sorinbotirla/parkside-telemeter-esp32cam-rangefinder/notes.txt

SDA pin 13 white
SCL pin 2 blue
keyoard pin 14 white/transparent
power pin 15 red/black
