sorinbotirla/parkside-telemeter-esp32cam-rangefinder/images/20251103_020656.jpg

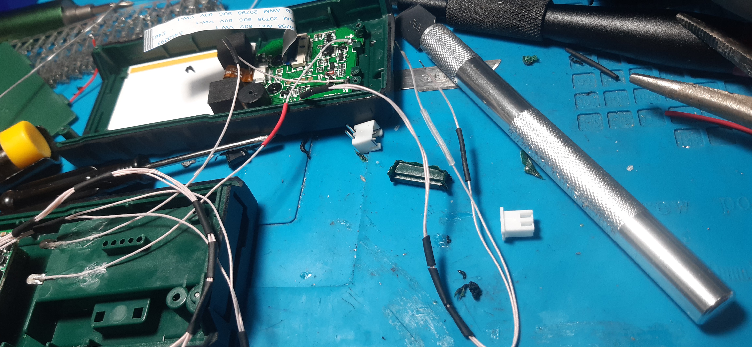
images/20251103_020656.jpg
