sorinbotirla/parkside-telemeter-esp32cam-rangefinder/images/20251116_204047.jpg

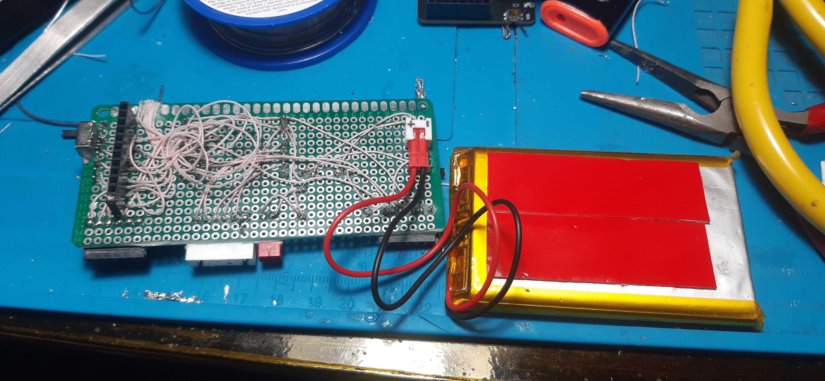
images/20251116_204047.jpg
