sorinbotirla/parkside-telemeter-esp32cam-rangefinder/images/20251116_204103.jpg

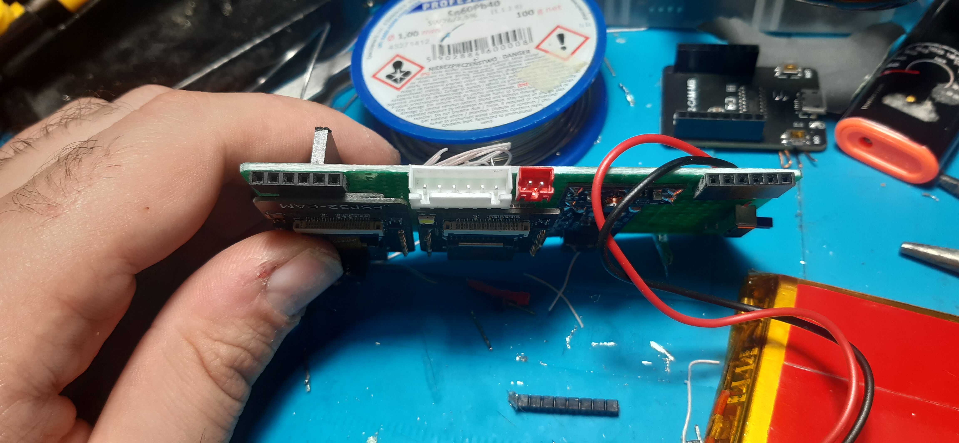
images/20251116_204103.jpg
