sorinbotirla/parkside-telemeter-esp32cam-rangefinder/images/20251119_194628.jpg

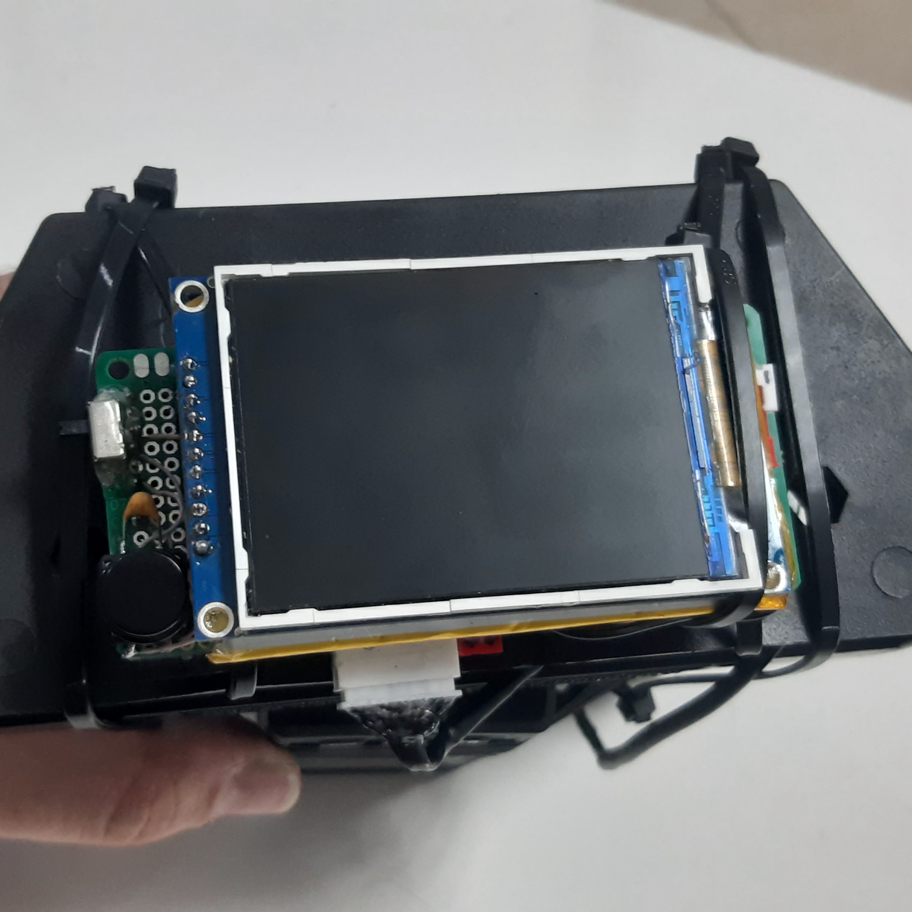
images/20251119_194628.jpg
