sorinbotirla/parkside-telemeter-esp32cam-rangefinder/images/20251119_194636.jpg

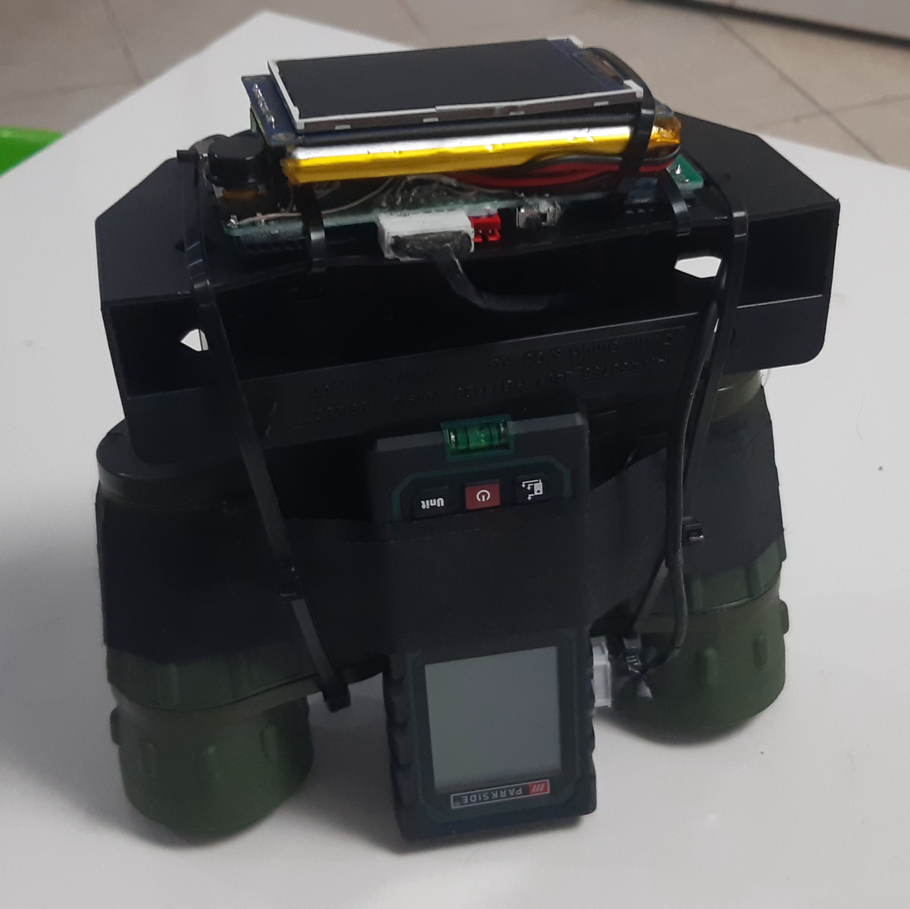
images/20251119_194636.jpg
