sorinbotirla/parkside-telemeter-esp32cam-rangefinder/images/esp32s-pinout.png

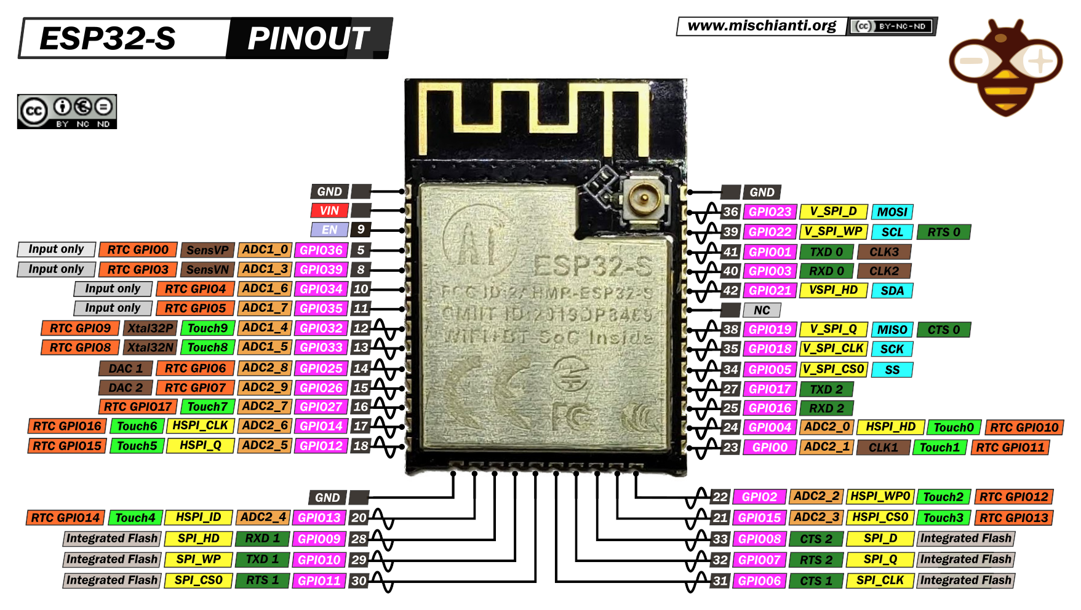
images/esp32s-pinout.png
