sorinbotirla/parkside-telemeter-esp32cam-rangefinder/images/F09LCGRLXEP8742.jpg

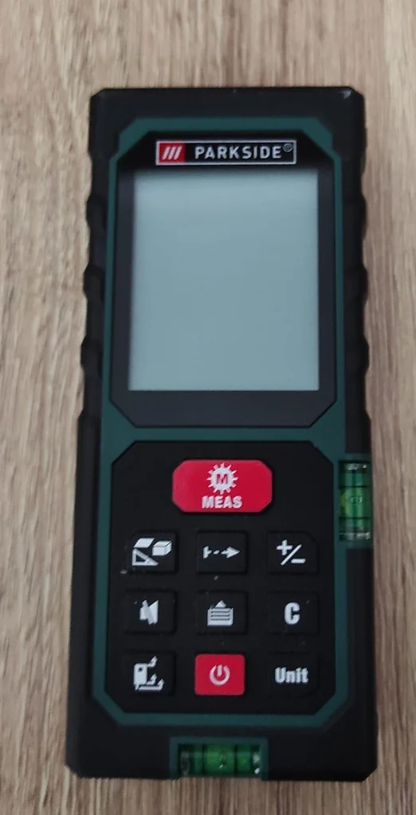
images/F09LCGRLXEP8742.jpg
