sorinbotirla/parkside-telemeter-esp32cam-rangefinder/cameradisplay/cameradisplay.ino

#include <Arduino.h>
#include "esp_camera.h"
#include <TFT_eSPI.h>

// ====================================================
// TFT DISPLAY
// ====================================================
TFT_eSPI tft = TFT_eSPI();
#define TFT_ROTATION 1

// ====================================================
// UART2 – receives distance from telemeter board
// ====================================================

// NOTE: GPIO4 is used here.
// This ONLY works if the flash LED on GPIO4 is removed.
// If you want RX2 on GPIO13 instead, tell me.

#define UART2_RX_PIN 13
#define UART2_TX_PIN -1   // unused

String lastDistance = "0m";   // <-- default value

// Crosshair
#define CROSS_LEN  12   // line length
#define CROSS_GAP   4   // empty center space

// Laser icon
bool laserActive = false;
#define LASER_ICON_W 33
#define LASER_ICON_H 33

// 'LaserIcon', 33x33px
static const uint16_t laserIcon[1089] = {
  0xFFFF, 0xFFFF, 0xFFFF, 0xFFFF, 0xFFFF, 0xFFFF, 0xFFFF, 0xFFFF, 0xFFFF, 0xFFFF, 0xFFFF, 0xFFFF,
  0xFFFF, 0xFFFF, 0xFFFF, 0xF800, 0xF800, 0xF800, 0xFFFF, 0xFFFF, 0xFFFF, 0xFFFF, 0xFFFF, 0xFFFF,
  0xFFFF, 0xFFFF, 0xFFFF, 0xFFFF, 0xFFFF, 0xFFFF, 0xFFFF, 0xFFFF, 0xFFFF, 0xFFFF, 0xFFFF, 0xFFFF,
  0xFFFF, 0xFFFF, 0xFFFF, 0xFFFF, 0xFFFF, 0xFFFF, 0xFFFF, 0xFFFF, 0xFFFF, 0xFFFF, 0xFFFF, 0xF800,
  0xF800, 0xF800, 0xF800, 0xF800, 0xFFFF, 0xFFFF, 0xFFFF, 0xFFFF, 0xFFFF, 0xFFFF, 0xFFFF, 0xFFFF,
  0xFFFF, 0xFFFF, 0xFFFF, 0xFFFF, 0xFFFF, 0xFFFF, 0xFFFF, 0xFFFF, 0xFFFF, 0xFFFF, 0xFFFF, 0xFFFF,
  0xFFFF, 0xFFFF, 0xFFFF, 0xFFFF, 0xFFFF, 0xFFFF, 0xFFFF, 0xFFFF, 0xF800, 0xF800, 0xF800, 0xF800,
  0xF800, 0xFFFF, 0xFFFF, 0xFFFF, 0xFFFF, 0xFFFF, 0xFFFF, 0xFFFF, 0xFFFF, 0xFFFF, 0xFFFF, 0xFFFF,
  0xFFFF, 0xFFFF, 0xFFFF, 0xFFFF, 0xFFFF, 0xFFFF, 0xFFFF, 0xFFFF, 0xFFFF, 0xFFFF, 0xFFFF, 0xFFFF,
  0xFFFF, 0xFFFF, 0xFFFF, 0xFFFF, 0xFFFF, 0xF800, 0xF800, 0xF800, 0xF800, 0xF800, 0xFFFF, 0xFFFF,
  0xFFFF, 0xFFFF, 0xFFFF, 0xFFFF, 0xFFFF, 0xFFFF, 0xFFFF, 0xFFFF, 0xFFFF, 0xFFFF, 0xFFFF, 0xFFFF,
  0xFFFF, 0xFFFF, 0xFFFF, 0xFFFF, 0xFFFF, 0xF800, 0xF800, 0xF800, 0xFFFF, 0xFFFF, 0xFFFF, 0xFFFF,
  0xFFFF, 0xFFFF, 0xF800, 0xF800, 0xF800, 0xF800, 0xF800, 0xFFFF, 0xFFFF, 0xFFFF, 0xFFFF, 0xFFFF,
  0xFFFF, 0xFFFF, 0xFFFF, 0xFFFF, 0xFFFF, 0xFFFF, 0xFFFF, 0xFFFF, 0xFFFF, 0xFFFF, 0xFFFF, 0xFFFF,
  0xFFFF, 0xF800, 0xF800, 0xF800, 0xF800, 0xF800, 0xFFFF, 0xFFFF, 0xFFFF, 0xFFFF, 0xFFFF, 0xF800,
  0xF800, 0xF800, 0xF800, 0xF800, 0xFFFF, 0xFFFF, 0xFFFF, 0xFFFF, 0xFFFF, 0xF800, 0xF800, 0xF800,
  0xFFFF, 0xFFFF, 0xFFFF, 0xFFFF, 0xFFFF, 0xFFFF, 0xFFFF, 0xFFFF, 0xFFFF, 0xFFFF, 0xF800, 0xF800,
  0xF800, 0xF800, 0xF800, 0xF800, 0xFFFF, 0xFFFF, 0xFFFF, 0xFFFF, 0xF800, 0xF800, 0xF800, 0xF800,
  0xF800, 0xFFFF, 0xFFFF, 0xFFFF, 0xFFFF, 0xF800, 0xF800, 0xF800, 0xF800, 0xF800, 0xFFFF, 0xFFFF,
  0xFFFF, 0xFFFF, 0xFFFF, 0xFFFF, 0xFFFF, 0xFFFF, 0xFFFF, 0xF800, 0xF800, 0xF800, 0xF800, 0xF800,
  0xF800, 0xF800, 0xFFFF, 0xFFFF, 0xFFFF, 0xF800, 0xF800, 0xF800, 0xF800, 0xF800, 0xFFFF, 0xFFFF,
  0xFFFF, 0xF800, 0xF800, 0xF800, 0xF800, 0xF800, 0xF800, 0xFFFF, 0xFFFF, 0xFFFF, 0xFFFF, 0xFFFF,
  0xFFFF, 0xFFFF, 0xFFFF, 0xFFFF, 0xFFFF, 0xF800, 0xF800, 0xF800, 0xF800, 0xF800, 0xF800, 0xF800,
  0xFFFF, 0xFFFF, 0xF800, 0xF800, 0xF800, 0xF800, 0xF800, 0xFFFF, 0xFFFF, 0xF800, 0xF800, 0xF800,
  0xF800, 0xF800, 0xF800, 0xF800, 0xFFFF, 0xFFFF, 0xFFFF, 0xFFFF, 0xFFFF, 0xFFFF, 0xFFFF, 0xFFFF,
  0xFFFF, 0xFFFF, 0xFFFF, 0xF800, 0xF800, 0xF800, 0xF800, 0xF800, 0xF800, 0xFFFF, 0xFFFF, 0xF8A2,
  0xF841, 0xF800, 0xF800, 0xF800, 0xFFFF, 0xFFFF, 0xF800, 0xF800, 0xF800, 0xF800, 0xF800, 0xF800,
  0xFFFF, 0xFFFF, 0xFFFF, 0xFFFF, 0xFFFF, 0xFFFF, 0xFFFF, 0xFFFF, 0xFFFF, 0xFFFF, 0xFFFF, 0xFFFF,
  0xFFFF, 0xF800, 0xF800, 0xF800, 0xF800, 0xF800, 0xFFFF, 0xFFFF, 0xFFFF, 0xFFFF, 0xFFFF, 0xFFFF,
  0xFFFF, 0xFFFF, 0xFFFF, 0xF800, 0xF800, 0xF800, 0xF800, 0xF800, 0xFFFF, 0xFFFF, 0xFFFF, 0xFFFF,
  0xFFFF, 0xFFFF, 0xFFFF, 0xFFFF, 0xFFFF, 0xFFFF, 0xFFFF, 0xFFFF, 0xFFFF, 0xFFFF, 0xFFFF, 0xF800,
  0xF800, 0xF800, 0xFFFF, 0xFFFF, 0xFFFF, 0xFFFF, 0xFFFF, 0xFFFF, 0xFFFF, 0xFFFF, 0xFFFF, 0xFFFF,
  0xFFFF, 0xF800, 0xF800, 0xF800, 0xFFFF, 0xFFFF, 0xFFFF, 0xFFFF, 0xFFFF, 0xFFFF, 0xFFFF, 0xFFFF,
  0xFFFF, 0xFFFF, 0xFFFF, 0xFFFF, 0xFFFF, 0xFFFF, 0xFFFF, 0xFFFF, 0xFFFF, 0xFFFF, 0xFFFF, 0xFFFF,
  0xFFFF, 0xFFFF, 0xFFFF, 0xFFFF, 0xFFFF, 0xFFFF, 0xFFFF, 0xFFFF, 0xFFFF, 0xFFFF, 0xFFFF, 0xFFFF,
  0xFFFF, 0xFFFF, 0xFFFF, 0xFFFF, 0xFFFF, 0xFFFF, 0xFFFF, 0xFFFF, 0xFFFF, 0xFFFF, 0xFFFF, 0xFFFF,
  0xFFFF, 0xFFFF, 0xFFFF, 0xFFFF, 0xFFFF, 0xFFFF, 0xFFFF, 0xFFFF, 0xFFFF, 0xFFFF, 0xFFFF, 0xF800,
  0xF800, 0xF800, 0xF800, 0xFFFF, 0xFFFF, 0xFFFF, 0xFFFF, 0xFFFF, 0xFFFF, 0xFFFF, 0xFFFF, 0xFFFF,
  0xFFFF, 0xFFFF, 0xFFFF, 0xFFFF, 0xFFFF, 0xFFFF, 0xFFFF, 0xF800, 0xF800, 0xF800, 0xF800, 0xF800,
  0xF800, 0xF800, 0xF800, 0xF800, 0xFFFF, 0xFFFF, 0xFFFF, 0xF800, 0xF800, 0xF800, 0xF800, 0xF800,
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
};




// ====================================================
// HISTORY OF MEASUREMENTS (right side of screen)
// ====================================================

static const int MAX_HISTORY       = 6;  // how many old values to remember
static const int HIST_AREA_WIDTH   = 40;  // approx width used on the right side
static const int HIST_LINE_HEIGHT  = 12;  // vertical spacing for lines

String historyValues[MAX_HISTORY];
int    historyCount = 0;

void addHistoryEntry(const String &val) {
  if (val.length() == 0) return;
  if (val == "0m") return; // avoid storing the initial placeholder

  if (historyCount < MAX_HISTORY) {
    historyValues[historyCount++] = val;
  } else {
    // shift up, drop oldest
    for (int i = 1; i < MAX_HISTORY; i++) {
      historyValues[i - 1] = historyValues[i];
    }
    historyValues[MAX_HISTORY - 1] = val;
  }
}

// ====================================================
// ESP32-CAM AI THINKER PIN DEFINITIONS
// ====================================================

#define PWDN_GPIO_NUM     32
#define RESET_GPIO_NUM    -1
#define XCLK_GPIO_NUM      0
#define SIOD_GPIO_NUM     26
#define SIOC_GPIO_NUM     27

#define Y9_GPIO_NUM       35
#define Y8_GPIO_NUM       34
#define Y7_GPIO_NUM       39
#define Y6_GPIO_NUM       36
#define Y5_GPIO_NUM       21
#define Y4_GPIO_NUM       19
#define Y3_GPIO_NUM       18
#define Y2_GPIO_NUM        5

#define VSYNC_GPIO_NUM    25
#define HREF_GPIO_NUM     23
#define PCLK_GPIO_NUM     22

// ====================================================
// CAMERA INIT
// ====================================================

bool init_camera() {
  camera_config_t c;

  c.ledc_channel = LEDC_CHANNEL_0;
  c.ledc_timer   = LEDC_TIMER_0;

  c.pin_d0 = Y2_GPIO_NUM;
  c.pin_d1 = Y3_GPIO_NUM;
  c.pin_d2 = Y4_GPIO_NUM;
  c.pin_d3 = Y5_GPIO_NUM;
  c.pin_d4 = Y6_GPIO_NUM;
  c.pin_d5 = Y7_GPIO_NUM;
  c.pin_d6 = Y8_GPIO_NUM;
  c.pin_d7 = Y9_GPIO_NUM;

  c.pin_xclk = XCLK_GPIO_NUM;
  c.pin_pclk = PCLK_GPIO_NUM;
  c.pin_vsync = VSYNC_GPIO_NUM;
  c.pin_href  = HREF_GPIO_NUM;

  c.pin_sccb_sda = SIOD_GPIO_NUM;
  c.pin_sccb_scl = SIOC_GPIO_NUM;

  c.pin_pwdn  = PWDN_GPIO_NUM;
  c.pin_reset = RESET_GPIO_NUM;

  c.xclk_freq_hz = 20000000;

  c.frame_size   = FRAMESIZE_QVGA;     // 320x240
  c.pixel_format = PIXFORMAT_RGB565;   // for TFT
  c.fb_count     = 2;
  c.grab_mode    = CAMERA_GRAB_LATEST;
  c.fb_location  = psramFound() ? CAMERA_FB_IN_PSRAM : CAMERA_FB_IN_DRAM;

  esp_err_t err = esp_camera_init(&c);
  return (err == ESP_OK);
}

// ====================================================
// DRAW OVERLAY - White text bottom-center, no box
// ====================================================

void drawDistanceOverlay(const String &s) {
  tft.setTextColor(TFT_WHITE, TFT_BLACK /*ignored unless background enabled*/);
  tft.setTextSize(2);

  int16_t textW = tft.textWidth(s);
  int16_t x = (320 - textW) / 2;
  int16_t y = 240 - 26 + 4;  // bottom area

  // Draw text only, no background
  tft.setCursor(x, y);
  tft.print(s);
}

// ====================================================
// DRAW HISTORY OVERLAY - Right side, yellow text, no box
// ====================================================

void drawHistoryOverlay() {
  if (historyCount == 0) return;

  tft.setTextSize(1);     // small font so it fits in the strip
  tft.setTextColor(TFT_GREEN, TFT_BLACK /*ignored unless background enabled*/);

  int16_t x = 320 - HIST_AREA_WIDTH + 2;
  int16_t y = 240 - HIST_LINE_HEIGHT;  // start from bottom

  // draw from newest (bottom) to oldest (top)
  for (int i = historyCount - 1; i >= 0; i--) {
    if (y < 0) break;  // off-screen
    tft.setCursor(x, y);
    tft.print(historyValues[i]);
    y -= HIST_LINE_HEIGHT;
  }
}

// ====================================================
// NORMALIZE/VALIDATE DISTANCE STRINGS
// ====================================================

String normalizeDistance(const String &raw) {
  String s = raw;
  s.trim();

  // Case: 255 (no unit)
  if (s == "255") {
    return lastDistance;
  }
    
  // Case: telemeter sends "---" or empty
  if (s == "---" || s.length() == 0) {
    return lastDistance;
  }

  // Case: must end with 'm'
  if (!s.endsWith("m")) {
    return lastDistance;
  }

  // Remove the trailing 'm'
  String numberPart = s.substring(0, s.length() - 1);

  // Validate the number part: digits or digits+dot
  bool valid = true;
  bool dotSeen = false;

  for (int i = 0; i < numberPart.length(); i++) {
    char c = numberPart[i];
    if (c >= '0' && c <= '9') continue;
    if (c == '.' && !dotSeen) {
      dotSeen = true;
      continue;
    }
    valid = false;
    break;
  }

  if (!valid || numberPart.length() == 0) {
    return lastDistance;
  }

  // Everything valid, return "[number]m"
  return numberPart + "m";
}

void drawCrosshair() {
  int cx = 160;   // center of 320
  int cy = 120;   // center of 240

  int len = CROSS_LEN;
  int gap = CROSS_GAP;

  tft.drawLine(cx - gap - len, cy, cx - gap - 1, cy, TFT_YELLOW); // left
  tft.drawLine(cx + gap + 1,  cy, cx + gap + len, cy,  TFT_YELLOW); // right
  tft.drawLine(cx, cy - gap - len, cx, cy - gap - 1, TFT_YELLOW); // top
  tft.drawLine(cx, cy + gap + 1,  cx, cy + gap + len, TFT_YELLOW); // bottom
}

void drawLaserIcon(int x, int y) {
  int idx = 0;
  for (int row = 0; row < LASER_ICON_H; row++) {
    for (int col = 0; col < LASER_ICON_W; col++, idx++) {
      uint16_t c = laserIcon[idx];
      if (c != 0xFFFF) { // 0xFFFF = white
        tft.drawPixel(x + col, y + row, c);
      }
    }
  }
}
// ====================================================
// SETUP
// ====================================================

void setup() {
  Serial.begin(115200);
  delay(200);

  // UART from telemeter ESP32
  Serial2.begin(115200, SERIAL_8N1, UART2_RX_PIN, UART2_TX_PIN);

  // GPIO4 flash LED must stay OFF
  pinMode(4, OUTPUT);
  digitalWrite(4, LOW);

  // Camera
  if (!init_camera()) {
    Serial.println("Camera init FAILED");
    while (true) delay(500);
  }

  // TFT
  tft.init();
  tft.setRotation(TFT_ROTATION);
  tft.fillScreen(TFT_BLACK);

  Serial.println("Camera + TFT board ready.");
}

// ====================================================
// LOOP
// ====================================================

void loop() {

  // ---- 1. Read distance from telemeter board ----
 while (Serial2.available()) {
    String line = Serial2.readStringUntil('\n');
    line.trim();
    if (line.length() > 0) {

      // Detect "-----" (laser on, waiting for measure)
      if (line == "-----m") {
        laserActive = true;
        // Do NOT push into history, do NOT change lastDistance
        Serial.println("rx status: LASER ON (-----m)");
      } else {
        laserActive = false;

        // Normalize/filter the incoming distance
        String formatted = normalizeDistance(line);

        // If the formatted value changed, push the previous one into history
        if (formatted != lastDistance) {
          if (lastDistance.length() > 0 && lastDistance != "0m") {
            addHistoryEntry(lastDistance);
          }
          lastDistance = formatted;
        }

        Serial.print("rx distance raw: ");
        Serial.println(line);
        Serial.print("rx distance normalized: ");
        Serial.println(lastDistance);
      }
    }
  }

  // ---- 2. Capture camera frame ----
  camera_fb_t *fb = esp_camera_fb_get();
  if (!fb) return;

  // ---- 3. Draw image ----
  if (fb->format == PIXFORMAT_RGB565 &&
      fb->width  == 320 &&
      fb->height == 240) {

    tft.pushImage(0, 0, 320, 240, (uint16_t*)fb->buf);

    // Draw overlays ON TOP of the camera image
    drawCrosshair();                   // centered, yellow
    drawDistanceOverlay(lastDistance); // bottom, white
    drawHistoryOverlay();              // right, green

    if (laserActive) {
      // top-right, adjust if you like
      int iconX = 2;
      int iconY = 2;
      drawLaserIcon(iconX, iconY);
    }
  }

  esp_camera_fb_return(fb);
}
