sorinbotirla/parkside-telemeter-esp32cam-rangefinder/cameratest/cameratest.ino

#include <Arduino.h>
#include "esp_camera.h"
#include <TFT_eSPI.h>

TFT_eSPI tft = TFT_eSPI();

// ========== CAMERA PINS (AI Thinker ESP32-CAM) ==========
#define PWDN_GPIO_NUM     32
#define RESET_GPIO_NUM    -1
#define XCLK_GPIO_NUM      0
#define SIOD_GPIO_NUM     26
#define SIOC_GPIO_NUM     27

#define Y9_GPIO_NUM       35
#define Y8_GPIO_NUM       34
#define Y7_GPIO_NUM       39
#define Y6_GPIO_NUM       36
#define Y5_GPIO_NUM       21
#define Y4_GPIO_NUM       19
#define Y3_GPIO_NUM       18
#define Y2_GPIO_NUM        5
#define VSYNC_GPIO_NUM    25
#define HREF_GPIO_NUM     23
#define PCLK_GPIO_NUM     22

void setup() {
  Serial.begin(115200);
  delay(300);

  // Disable flash LED
  pinMode(4, OUTPUT);
  digitalWrite(4, LOW);

  // Initialize TFT
  tft.init();
  tft.setRotation(1);
  tft.fillScreen(TFT_BLACK);
  tft.setTextColor(TFT_GREEN, TFT_BLACK);
  tft.drawString("Initializing camera...", 10, 10, 2);

  // Camera configuration
  camera_config_t config;
  config.ledc_channel = LEDC_CHANNEL_0;
  config.ledc_timer   = LEDC_TIMER_0;

  config.pin_d0 = Y2_GPIO_NUM;
  config.pin_d1 = Y3_GPIO_NUM;
  config.pin_d2 = Y4_GPIO_NUM;
  config.pin_d3 = Y5_GPIO_NUM;
  config.pin_d4 = Y6_GPIO_NUM;
  config.pin_d5 = Y7_GPIO_NUM;
  config.pin_d6 = Y8_GPIO_NUM;
  config.pin_d7 = Y9_GPIO_NUM;

  config.pin_xclk = XCLK_GPIO_NUM;
  config.pin_pclk = PCLK_GPIO_NUM;
  config.pin_vsync = VSYNC_GPIO_NUM;
  config.pin_href  = HREF_GPIO_NUM;

  config.pin_sscb_sda = SIOD_GPIO_NUM;
  config.pin_sscb_scl = SIOC_GPIO_NUM;

  config.pin_pwdn  = PWDN_GPIO_NUM;
  config.pin_reset = RESET_GPIO_NUM;

  config.xclk_freq_hz = 20000000;
  config.frame_size   = FRAMESIZE_QVGA;
  config.pixel_format = PIXFORMAT_RGB565;   // RGB565
  config.fb_count     = 2;
  config.grab_mode    = CAMERA_GRAB_LATEST;
  config.fb_location  = CAMERA_FB_IN_PSRAM;

  // Init camera
  esp_err_t err = esp_camera_init(&config);
  if (err != ESP_OK) {
    tft.fillScreen(TFT_BLACK);
    tft.drawString("Camera init FAILED", 10, 10, 2);
    Serial.printf("Camera error: 0x%x\n", err);
    while (true) delay(1000);
  }

  tft.fillScreen(TFT_BLACK);
  tft.drawString("Camera OK", 10, 10, 2);
  delay(500);
  tft.fillScreen(TFT_BLACK);
}

void loop() {
  camera_fb_t *fb = esp_camera_fb_get();
  if (!fb) return;

  // The OV2640 sometimes outputs swapped RGB565.
  // So we use the TFT_eSPI swap-bytes version:
  tft.pushImage(0, 0, fb->width, fb->height, (uint16_t*)fb->buf, true);

  esp_camera_fb_return(fb);
}
